ajkumar-1907/ev-charging-design/calcs/EV_Charging_Design_Calcs.xlsx

Sheet: Cover
EV Charging Infrastructure Design: Commercial Office Building
Prepared by Anuj Kumar (B.Tech EE, DTU). Portfolio design exercise
Scope
 | 6 EV charging points (4 x 7.4 kW AC + 2 x 30 kW DC) for the parking of a 1,800 m² G+2 commercial office in Delhi.
 | Shows the transformer impact with and without dynamic load management (DLM), an hourly DLM profile, the EV DB feeder and the final circuits.
 | Host building data are taken from the companion project 'Electrical Design of a G+2 Commercial Office Building' (Rev 0). In that design this EV DB replaces the 2 x 7.4 kW provision on feeder F09.
 | Change the host-building inputs and this workbook can be applied to any other building.
Sheets
Inputs | Host building data, supply, margins, derating, charging-use assumptions
Chargers | Parking requirement (MoHUA bye-laws), charger schedule, phase allocation
Transformer_Impact | Building MD with and without DLM; DLM peak cap that keeps the 315 kVA transformer
Hourly_DLM | 24-hour office load profile, EV power available each hour, daily energy check, chart
Cables | MLTP to EV DB feeder (Al XLPE) and one final circuit per charger (Cu XLPE)
Pricing | AC vs DC user price (MoP 2024 tariff structure), revenue and payback
Ref_Tables | Havells cable data, standard breaker and transformer ratings
Colour legend
Blue text, yellow fill | Input: edit these
Black text | Formula
Green text | Link from another sheet
Green fill | Key result
Standards & sources
 | IEC 61851-1 / -23 and IS 17017 (EV conductive charging); IEC 60364-7-722 (supplies for EVs); IS 732; IEC 60364-5-52
 | MoHUA Model Building Bye-Laws 2016, amendment for EV charging infrastructure (2019): 20% of parking EV-ready
 | Ministry of Power, Guidelines for Installation and Operation of EV Charging Infrastructure (2024): reduced solar-hour tariff 9 AM–4 PM
 | Havells International Cables catalogue (Tables 16 and 20) for cable ampacity and resistance
Limitations
 | Parking count (30) and daily charging sessions are assumptions.
 | DLM cap uses a unity-PF approximation for EV load; the MD checks use the full kW/kVAr sum.
 | Office load profile is typical, not measured. Charger harmonics and RCD type must be confirmed with the charger maker.
 | Pricing: Delhi EV tariff from the 2019 DERC order (verify current schedule); charger costs and usage are approximate assumptions.

Sheet: Inputs
Design inputs
Parameter | Value | Unit | Basis / note
HOST BUILDING (from G+2 project, Rev 0)
Non-EV feeder demand, active | 166.12 | kW | G+2 Load_Schedule: Σ MD of all feeders except EV (F09)
Non-EV feeder demand, reactive | 89.03 | kVAr | G+2 Load_Schedule
Overall diversity factor | 0.90 | - | Same as G+2
Existing transformer rating | 315 | kVA | G+2 Sizing sheet: 11/0.433 kV, Dyn11
Transformer max loading | 0.80 | - | Same as G+2
Future expansion margin | 20% | - | Same as G+2
LT system voltage (L-L) | 415 | V
LT voltage (L-N) | 240 | V
EV CHARGING USE
Car parking spaces | 30 | nos | Assumed for 1,800 m² office
EV-ready share of parking | 20% | - | MoHUA MBBL-2016 amendment (2019)
Daily charging sessions | 12 | nos | Assumed: 6 bays, about 2 sessions each per working day
Energy per session | 20 | kWh | Assumed average top-up
Charging window start | 8 | h | Office hours parking
Charging window end | 20 | h | Exclusive
EV power factor | 0.99 | - | Active front-end chargers
CABLES
Temperature derating factor | 0.87 | - | Havells: 45°C air
Grouping factor, MLTP feeder tray | 0.71 | - | Havells: multicore touching, 2 racks x 4
Grouping factor, EV final-circuit tray | 0.80 | - | Havells: multicore touching, 1 rack x 3
Voltage-drop limit | 3% | - | IS 732 / IEC 60364-5-52
MLTP to EV DB length | 40 | m | Parking adjacent to building

Sheet: Chargers
Charger schedule
A. Requirement
Item | Value | Unit / note
Charging points required | 6 | parking x 20%
Charging points provided | 6 | nos
Check | OK
B. Chargers
Tag | Charger | Connector / standard | Qty | Output (kW) | Efficiency | Input each (kW) | PF | Phases | Voltage (V) | Ib each (A) | Total input (kW) | Total (kVA)
EVC-AC | AC wallbox 7.4 kW, 32 A | Type 2, IEC 61851-1 / IS 17017 | 4 | 7.4 | 0.98 | 7.55 | 0.99 | 1 | 240 | 31.8 | 30.2 | 30.5
EVC-DC | DC fast charger 30 kW | CCS2, IEC 61851-23 / IS 17017 | 2 | 30.0 | 0.94 | 31.91 | 0.99 | 3 | 415 | 44.8 | 63.8 | 64.5
 | Total |  | 6 |  |  |  |  |  |  |  | 94.0 | 95.0
C. Phase allocation (connected kW)
Phase | AC chargers | AC kW | DC kW (balanced) | Total kW | vs average
R | 2 | 15.1 | 21.3 | 36.4 | +16.06021426%
Y | 1 | 7.6 | 21.3 | 28.8 | -+8.03010713%
B | 1 | 7.6 | 21.3 | 28.8 | -+8.03010713%
Two AC chargers share phase R (+13%). DLM allocates power phase-aware, so the R-phase pair is throttled first at peak.

Sheet: Transformer_Impact
Transformer impact and DLM cap
Item | Value | Unit / formula
Building MD without EV | 169.6 | kVA
Max building MD allowed on existing transformer | 210.0 | kVA = rating x 0.8 / 1.2
Headroom for EV at design MD | 40.4 | kVA
EV connected load | 94.0 | kW
CASE 1, no load management: building MD | 260.9 | kVA (EV not diversified)
Case 1 transformer required | 391.3 | kVA
Case 1 transformer selected | 400 | kVA
Allowable EV demand at office peak | 44.6 | kW (EV at unity PF, approx.)
CASE 2, DLM peak cap adopted | 40 | kW (rounded down to 5 kW)
Case 2 building MD | 208.0 | kVA
Case 2 transformer required | 312.1 | kVA
Check | OK: 315 kVA transformer retained
EV share available at peak | 42.53786479% | of connected EV load
Average power per charger at peak, all 6 in use | 6.7 | kW
Transformer loading at Case 2 MD | 66.04357571%
EV load is not diversified: under DLM it is a controlled, firm load. Without DLM the 94 kW of chargers would force a 400 kVA transformer. A 40 kW peak cap keeps building MD within 315 kVA x 0.8 / 1.2, preserving the 20% future margin.

Sheet: Hourly_DLM
Hourly DLM profile (typical working day)
EV power available = largest EV kW that keeps building MD within the design limit (rating x 0.8 / 1.2), capped at the chargers' connected load.
Hour | Office load (% of MD) | Building P (kW) | Building Q (kVAr) | EV available (kW) | In charging window? | EV energy in window (kWh)
00 | 25% | 37.4 | 20.0 | 94.0 | No | 0.0
01 | 25% | 37.4 | 20.0 | 94.0 | No | 0.0
02 | 25% | 37.4 | 20.0 | 94.0 | No | 0.0
03 | 25% | 37.4 | 20.0 | 94.0 | No | 0.0
04 | 25% | 37.4 | 20.0 | 94.0 | No | 0.0
05 | 25% | 37.4 | 20.0 | 94.0 | No | 0.0
06 | 25% | 37.4 | 20.0 | 94.0 | No | 0.0
07 | 40% | 59.8 | 32.1 | 94.0 | No | 0.0
08 | 60% | 89.7 | 48.1 | 94.0 | Yes | 94.0
09 | 85% | 127.1 | 68.1 | 71.6 | Yes | 71.6
10 | 100% | 149.5 | 80.1 | 44.6 | Yes | 44.6
11 | 100% | 149.5 | 80.1 | 44.6 | Yes | 44.6
12 | 100% | 149.5 | 80.1 | 44.6 | Yes | 44.6
13 | 100% | 149.5 | 80.1 | 44.6 | Yes | 44.6
14 | 100% | 149.5 | 80.1 | 44.6 | Yes | 44.6
15 | 100% | 149.5 | 80.1 | 44.6 | Yes | 44.6
16 | 100% | 149.5 | 80.1 | 44.6 | Yes | 44.6
17 | 90% | 134.6 | 72.1 | 62.7 | Yes | 62.7
18 | 70% | 104.7 | 56.1 | 94.0 | Yes | 94.0
19 | 50% | 74.8 | 40.1 | 94.0 | Yes | 94.0
20 | 40% | 59.8 | 32.1 | 94.0 | No | 0.0
21 | 30% | 44.9 | 24.0 | 94.0 | No | 0.0
22 | 30% | 44.9 | 24.0 | 94.0 | No | 0.0
23 | 25% | 37.4 | 20.0 | 94.0 | No | 0.0
Daily EV energy deliverable in window |  |  |  |  |  | 728.5724634
Daily EV energy needed (sessions x kWh) |  |  |  |  |  | 240
Check |  |  |  |  |  | OK: 3.0x the daily need
Lowest EV power in window (sets the DLM cap) |  |  |  |  |  | 44.6

Sheet: Cables
Cable schedule: EV DB feeder and final circuits
A. MLTP to EV DB feeder (Al XLPE, sized on full connected load: no DLM credit)
Tag | From | To | Load (kVA) | Ib (A) | Breaker In (A) | Iz needed (A) | Size (mm²) | Iz derated (A) | ΔV (%) | Check | Cable
F09 | Main LT Panel | EV Charger DB | 95.0 | 132.1 | 160 | 259.0254169 | 120 | 162.4551 | 0.74% | OK | 1R x 3.5C x 120 sq.mm Al XLPE armd, 40 m
B. Final circuits, one per charger (Cu XLPE). In ≥ 1.25 x Ib (charging is a continuous load)
Circuit | Charger | Phase | Ib (A) | Breaker In (A) | RCD | Iz needed (A) | Size Cu (mm²) | Length (m) | ΔV (%) | Check
EV-1 | EVC-AC | R | 31.8 | 40 | 30 mA Type A + 6 mA DC detection (in charger) | 57.5 | 10 | 25 | 1.54% | OK
EV-2 | EVC-AC | Y | 31.8 | 40 | 30 mA Type A + 6 mA DC detection (in charger) | 57.5 | 10 | 30 | 1.85% | OK
EV-3 | EVC-AC | B | 31.8 | 40 | 30 mA Type A + 6 mA DC detection (in charger) | 57.5 | 10 | 35 | 2.16% | OK
EV-4 | EVC-AC | R | 31.8 | 40 | 30 mA Type A + 6 mA DC detection (in charger) | 57.5 | 10 | 40 | 2.47% | OK
EV-5 | EVC-DC | RYB | 44.8 | 63 | 30 mA Type B (unless charger isolated) | 90.5 | 25 | 20 | 0.35% | OK
EV-6 | EVC-DC | RYB | 44.8 | 63 | 30 mA Type B (unless charger isolated) | 90.5 | 25 | 25 | 0.43% | OK
ΔV single-phase = 2·Z·I·L; three-phase = √3·Z·I·L. Each charger has its own circuit, RCD and protective earth (IEC 60364-7-722). EV DB is not on the DG bus.

Sheet: Pricing
Charging price, revenue and payback (AC vs DC)
EV DB separately sub-metered behind the building's HT connection (permitted by MoP 2024): single-part EV tariff, no demand charge. DC premium comes from the higher service-charge ceiling.
A. Tariff and charge inputs
Item | AC | DC | Basis / source
Base EV energy tariff (₹/kWh) | 4.50 | 4.50 | DERC EV tariff, LT (₹4.5/kWh, 2019 order). Verify current DISCOM schedule
Solar-hour multiplier (9 AM–4 PM) | 0.70 | 0.70 | MoP EV Charging Guidelines 2024: 0.7 x in solar hours
Non-solar-hour multiplier | 1.30 | 1.30 | MoP 2024: 1.3 x in non-solar hours
Service charge, solar hours (₹/kWh) | 3 | 11 | MoP 2024 ceiling: AC ₹3, DC ₹11 (valid to Mar 2028)
Service charge, non-solar hours (₹/kWh) | 4 | 13 | MoP 2024 ceiling: AC ₹4, DC ₹13
GST on charging service | 18% | 18% | 18% on the charging service
Charger efficiency (input energy / delivered) | 0.98 | 0.94 | From Chargers sheet: operator buys input energy
Share of energy delivered in solar hours | 60% | 40% | Assumed: AC = long-dwell staff cars in office hours; DC = more early/late top-ups (DLM limits EV power 10 AM–5 PM)
Sessions per working day | 6 | 6 | Assumed: 12 total, as on Inputs sheet
Energy per session (kWh) | 20 | 20 | Assumed, as on Inputs sheet
Working days per year | 300 | 300 | Assumed
Idle fee after 15-min grace (₹/min) | 0 | 5 | DC bays only, to free the fast charger. Not counted in revenue
B. Price to the EV user (₹/kWh, incl. GST)
Item | AC | DC | Formula
Energy pass-through, solar hours | 3.21 | 3.35 | tariff x multiplier / efficiency
Energy pass-through, non-solar hours | 5.97 | 6.22
User price, solar hours | 7.33 | 16.93 | (energy + service) x 1.18
User price, non-solar hours | 11.76 | 22.68
Weighted average user price | 9.11 | 20.38 | by solar-hour share
Cost of a 20 kWh session, solar hours | 146.6571429 | 338.6851064 | ₹
Cost of a 20 kWh session, non-solar hours | 235.277551 | 453.6723404 | ₹
Time for a 20 kWh session (h) | 2.7 | 0.7 | at full charger power
DC premium over AC (weighted price) |  | 123.8690654% | what the user pays for speed
C. Revenue and payback (operator view)
Item | AC | DC | Basis
Number of chargers | 4 | 2
Energy delivered per year (kWh) | 36000 | 36000 | sessions x kWh x days
Service revenue per year (₹, ex-GST) | 122400 | 439200 | energy is a pass-through; margin = service charge
Charger cost, installed (₹ each) | 70000 | 700000 | Approx. market: 7.4 kW wallbox ~₹0.5–0.8 L; 30 kW DC ~₹6–8 L. Replace with quotes
Share of EV DB, feeder and civil works (₹) | 100000 | 200000 | Approx. total ₹3 L split 1:2 (DC bays need more)
Total capex (₹) | 380000 | 1600000
O&M per year (% of capex) | 4% | 4% | Assumed
Charge-management software (₹ per charger per month) | 500 | 500 | Assumed CMS / OCPP backend fee
Operating cost per year (₹) | 39200 | 76000
Net margin per year (₹) | 83200 | 363200
Simple payback (years) | 4.6 | 4.4 | capex / net margin
Whole station payback (years) | 4.4 |  | total capex / total net margin
D. Design finding
1. Solar hours (9 AM–4 PM, cheapest energy and service charge) overlap the office peak (10 AM–5 PM), when DLM limits EV power to the cap.
2. So DLM gives priority to long-dwell AC charging in the day, and the DC bays are most useful before 10 AM and after 5 PM at the non-solar price.
3. The higher DC price reflects the faster service (about 0.7 h vs 2.7 h for 20 kWh) and the much higher charger cost, within the MoP ceilings.

Sheet: Ref_Tables
Reference tables
Al 3.5C/4C XLPE armd, air 30°C (Havells T16/T20) |  |  |  | Cu 4C XLPE armd, air 30°C (Havells T20)
Size (mm²) | Ampacity (A) | R @20°C (Ω/km) | mV/A/m 3-ph | Size (mm²) | Ampacity (A) | R @20°C (Ω/km) | Z @90°C (Ω/km) | Breaker In (A) | Transformer (kVA)
16 | 77 | 1.910 | 4.24 | 4 | 39 | 4.610 | 5.878 | 16 | 100
25 | 97 | 1.200 | 2.67 | 6 | 49 | 3.080 | 3.927 | 20 | 160
35 | 120 | 0.868 | 1.93 | 10 | 65 | 1.830 | 2.333 | 25 | 200
50 | 146 | 0.641 | 1.43 | 16 | 84 | 1.150 | 1.466 | 32 | 250
70 | 187 | 0.443 | 0.99 | 25 | 107 | 0.727 | 0.927 | 40 | 315
95 | 227 | 0.320 | 0.72 | 35 | 129 | 0.524 | 0.668 | 50 | 400
120 | 263 | 0.253 | 0.58 |  |  |  |  | 63 | 500
150 | 304 | 0.206 | 0.48 |  |  |  |  | 80 | 630
185 | 347 | 0.164 | 0.39 |  |  |  |  | 100 | 800
240 | 409 | 0.125 | 0.31 |  |  |  |  | 125 | 1000
 |  |  |  |  |  |  |  | 160
 |  |  |  |  |  |  |  | 200
 |  |  |  |  |  |  |  | 250
 |  |  |  |  |  |  |  | 320
 |  |  |  |  |  |  |  | 400
 |  |  |  |  |  |  |  | 500
 |  |  |  |  |  |  |  | 630
