ajkumar-1907/ev-charging-design/drawings/EV-EL-SLD-001.pdf

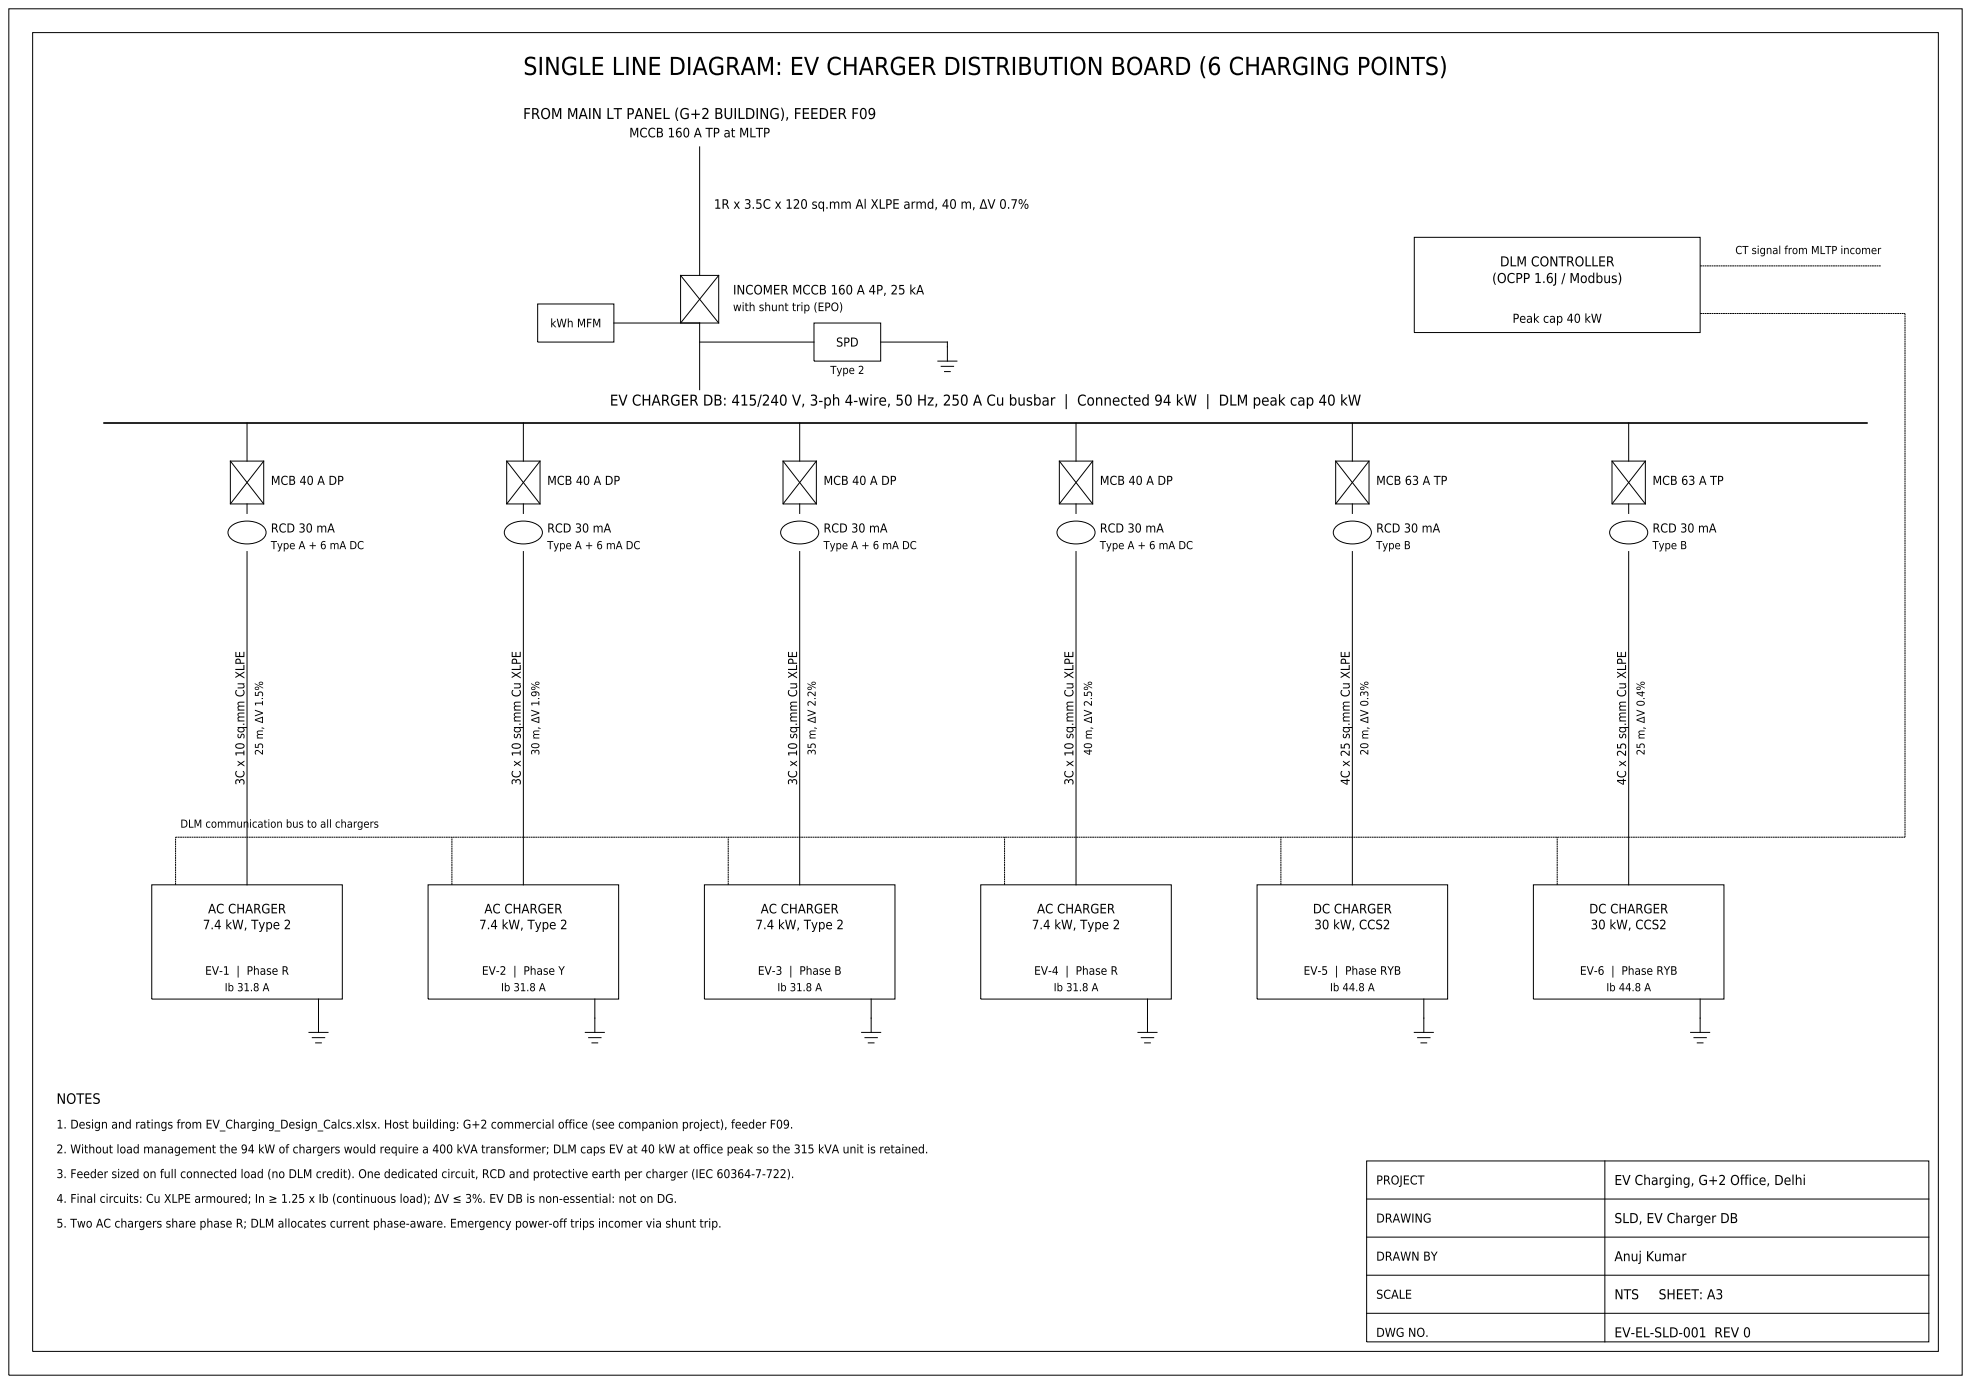
[picture p3: page 1]
