ajkumar-1907/ev-charging-design/drawings/EV-EL-SLD-001.dxf

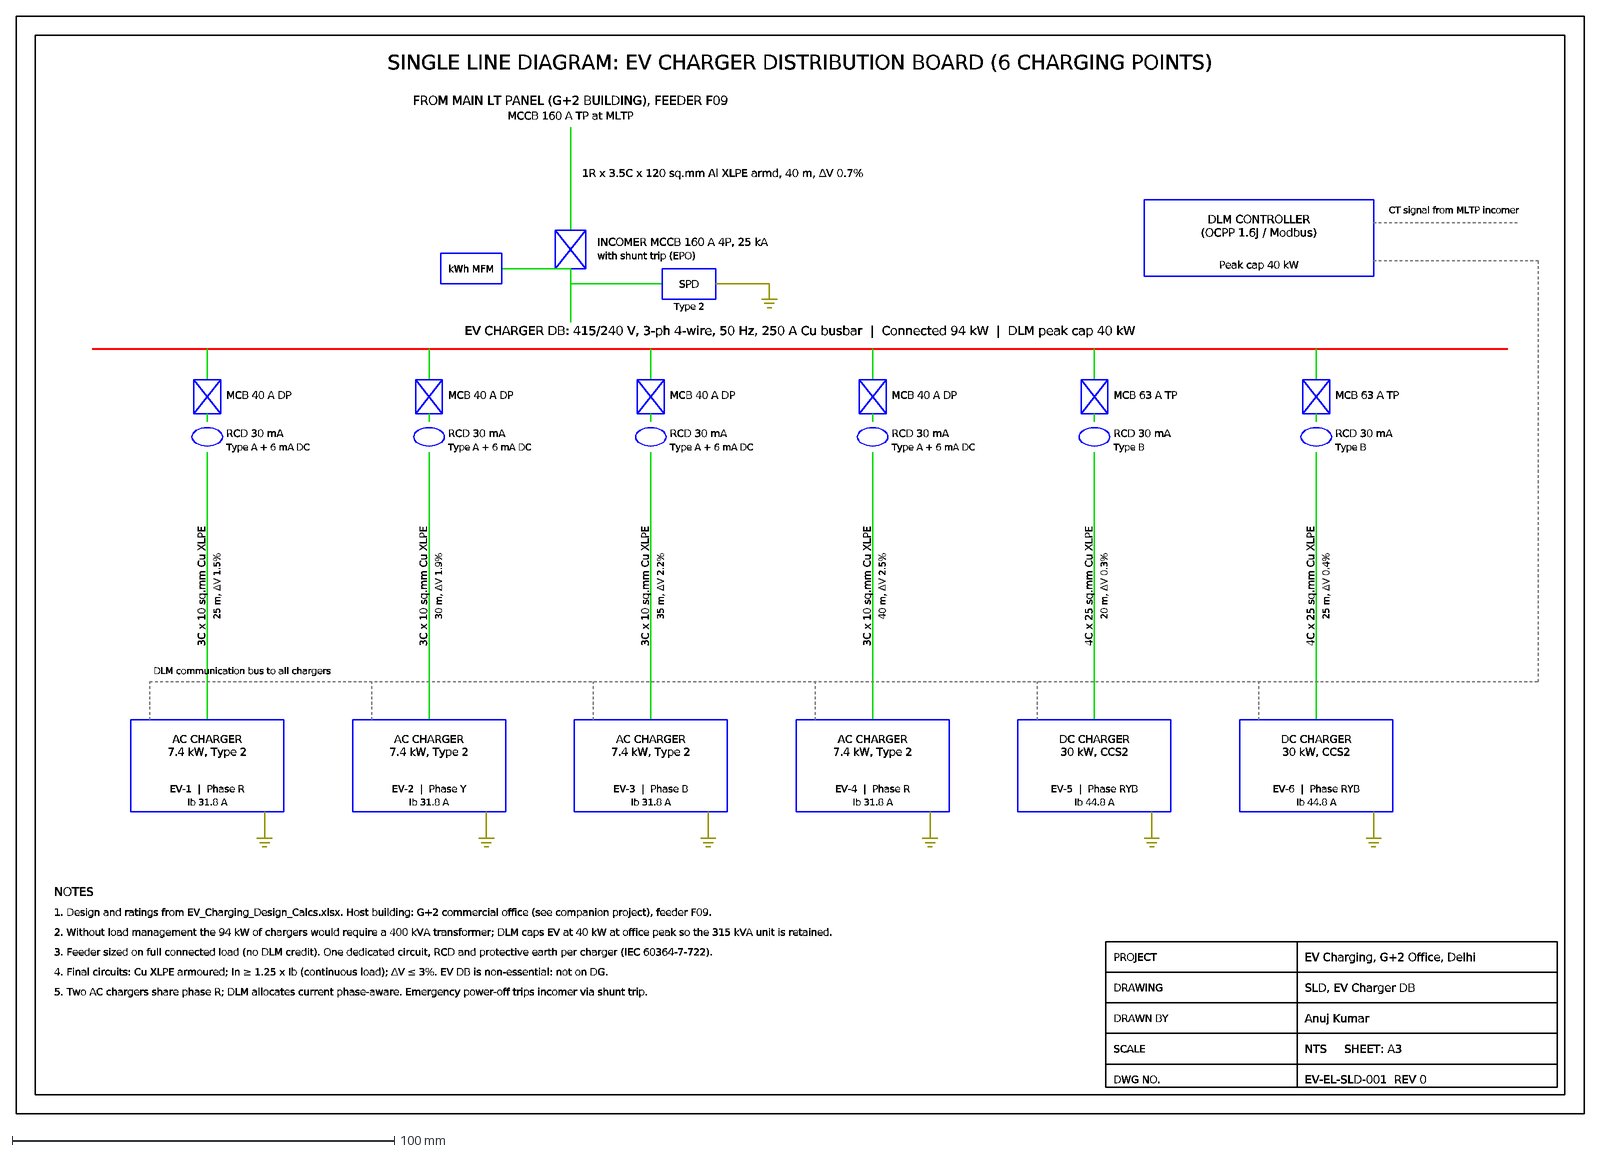
[picture p2: CAD file, 2026-10-22]
drawings/EV-EL-SLD-001.dxf
SINGLE LINE DIAGRAM: EV CHARGER DISTRIBUTION BOARD (6 CHARGING POINTS)
FROM MAIN LT PANEL (G+2 BUILDING), FEEDER F09
MCCB 160 A TP at MLTP
1R x 3.5C x 120 sq.mm Al XLPE armd, 40 m, ΔV 0.7%
INCOMER MCCB 160 A 4P, 25 kA
with shunt trip (EPO)
SPD
Type 2
kWh MFM
EV CHARGER DB: 415/240 V, 3-ph 4-wire, 50 Hz, 250 A Cu busbar | Connected 94 kW | DLM peak cap 40 kW
DLM CONTROLLER (OCPP 1.6J / Modbus)
Peak cap 40 kW
CT signal from MLTP incomer
MCB 40 A DP
RCD 30 mA
Type A + 6 mA DC
3C x 10 sq.mm Cu XLPE
25 m, ΔV 1.5%
AC CHARGER 7.4 kW, Type 2
EV-1 | Phase R
Ib 31.8 A
30 m, ΔV 1.9%
EV-2 | Phase Y
35 m, ΔV 2.2%
EV-3 | Phase B
40 m, ΔV 2.5%
EV-4 | Phase R
MCB 63 A TP
Type B
4C x 25 sq.mm Cu XLPE
20 m, ΔV 0.3%
DC CHARGER 30 kW, CCS2
EV-5 | Phase RYB
Ib 44.8 A
25 m, ΔV 0.4%
EV-6 | Phase RYB
DLM communication bus to all chargers
NOTES
1. Design and ratings from EV_Charging_Design_Calcs.xlsx. Host building: G+2 commercial office (see companion project), feeder F09.
2. Without load management the 94 kW of chargers would require a 400 kVA transformer; DLM caps EV at 40 kW at office peak so the 315 kVA unit is retained.
3. Feeder sized on full connected load (no DLM credit). One dedicated circuit, RCD and protective earth per charger (IEC 60364-7-722).
4. Final circuits: Cu XLPE armoured; In ≥ 1.25 x Ib (continuous load); ΔV ≤ 3%. EV DB is non-essential: not on DG.
5. Two AC chargers share phase R; DLM allocates current phase-aware. Emergency power-off trips incomer via shunt trip.
PROJECT
EV Charging, G+2 Office, Delhi
DRAWING
SLD, EV Charger DB
DRAWN BY
Anuj Kumar
SCALE
NTS SHEET: A3
DWG NO.
EV-EL-SLD-001 REV 0
